mobifu1/arduino_hf_power_meter/messkopf.pdf

# Messkopf fur die LCD-Anzeige ¨

# Aufbau und Abgleich

(c) DL4JAL, Andreas Lindenau
14. Februar 2010

Zusammenfassung
Fur die LCD-Anzeige mit SWR-Messung wird ein Messkopf ben ¨ | ötigt.
Hier folgt die Beschreibung und der Aufbau.

## Der Messkopf-Richtkoppler

Fur die Messung der Vorlaufspannung und R ¨ | ucklaufspannung ben ¨ | ötigen wir
einen Messkopf oder auch Richtkoppler genannt, der diese beiden Messgrößen möglichst frequenzlinear im Frequenzbereich 1,8 MHz bis mindestens 30MHz, besser 50MHz, in eine Gleichspannung umwandelt.

Aufbau des Messkopfes / Richtkopplers

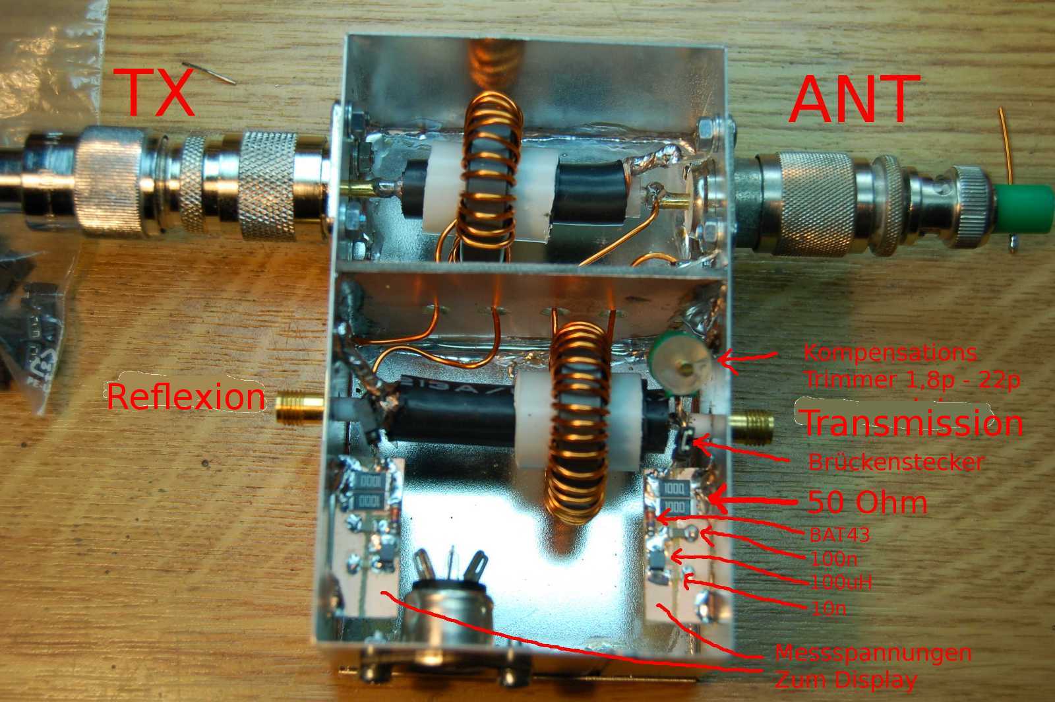
[picture p1: figure]

Ansicht des Messkopfes mit FT-114-43 als Auskopplungselemente. Oben links wird der Sender angeschlossen, oben rechts die Antenne. Die beiden SMA-
Buchsen dienen als Lötstutzpunkt und als Messbuchsen f ¨ | ur den Abgleich. Mit ¨

1

dem Bruckenstecker kann man den 50 Ohm Abschluss abtrennen. Das ist erfor- ¨ derlich wenn wir ein Messkabel anstecken. Auf den kleinen Leiterplatten befinden sich die Abschlusswiderstände 2 x 100 Ohm, die BAT43 zur Gleichrichtung und 2 Kondensatoren zur Glättung und die 100uH Drossel hält die HF von der Displayanzeige fern. Das Metallgehäuse habe ich bei Pollin bestellt fur 3,95 Eu- ¨ ro.

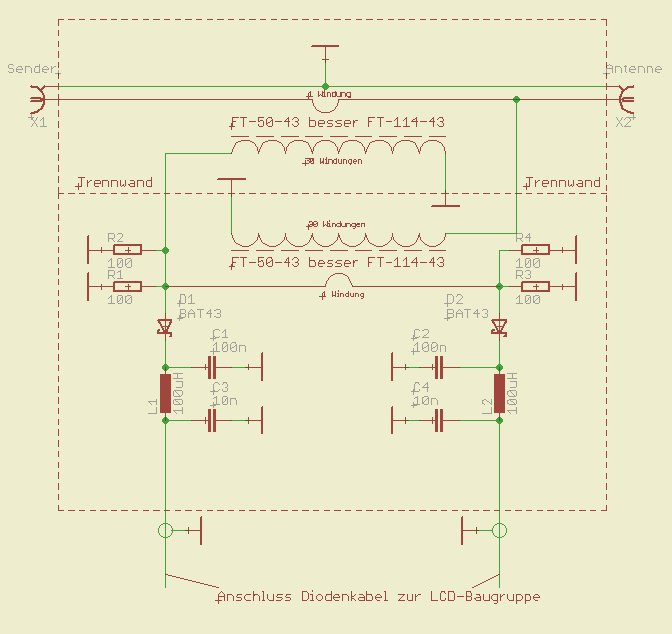
[picture p2: figure]

Das Schaltbild des Richtkopplers.

2

Das Kabel RG213 wird lang abgemantelt. Wir mussen aufpassen dass keine Fa- ¨ sern des Schirmes abstehen und eine Schluss verursachen.

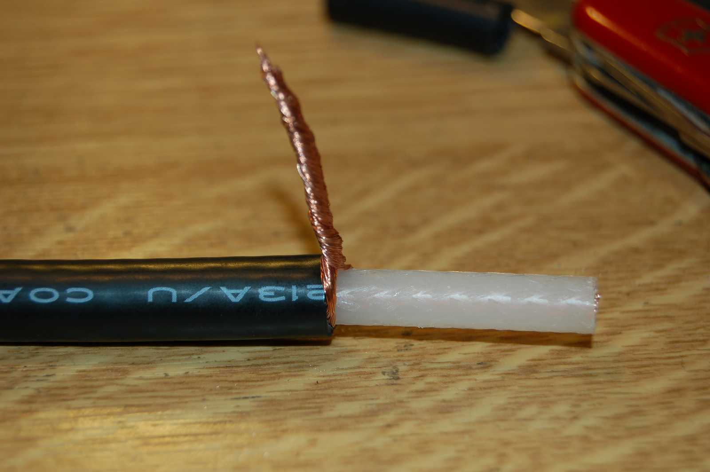
[picture p3: figure]

Deshalb wird die Masse lang verdrillt damit keine Ader frei herumhängt.

3

Die Seele wird ganz kurz abgesetzt um eine maximale Schirmung zu erreichen.

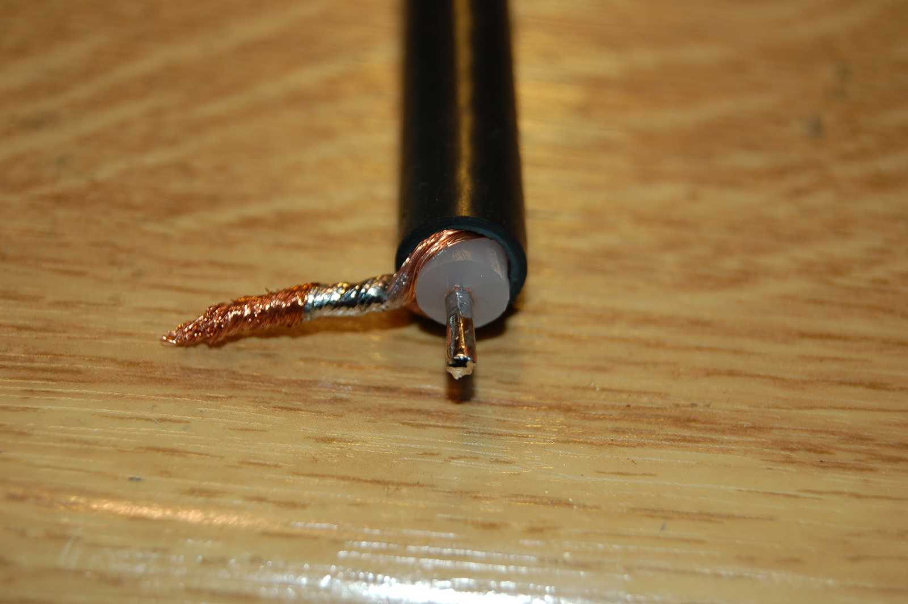
[picture p4: figure]

Masse und Seele gut verzinnen.

4

Die
2 Seite auch kurz absetzen und verzinnen. Achtung der Schirm wird hier abgeschnitten und darauf achten dass keine Fasern in Richtung Seele zeigen!!

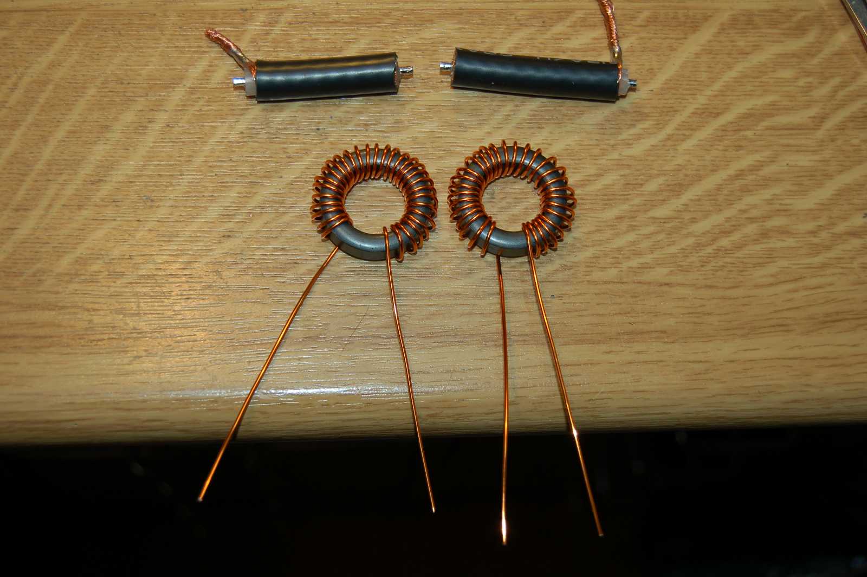
[picture p5: figure]

Wir sehen die fertigen Kabel und die bewickelten Ringkerne. Die Ringkerne bekommen 30 Windungen mit Kupferdraht 1mm Stärke. Es ist gut fur beide Kerne ¨ die gleichen Wickelrichtung zu verwenden. Beachtet man das nicht, kehrt sich die Auskopplung der Reflexion und Transmission um. Das ist nicht so schlimm, aber verwirrt etwas.

5

Die Ringkerne werden auf kurze Plasterohrstucke geschoben. Das Plasterohr ¨ habe ich aus dem Baumarkt. Der Außendurchmesser beträgt 16mm. Zwischen dem Plasterohr und dem RG213 ist noch Luft. Ich habe den Zwischenraum mit Kabelmantel vom RG213 gefullt. ¨

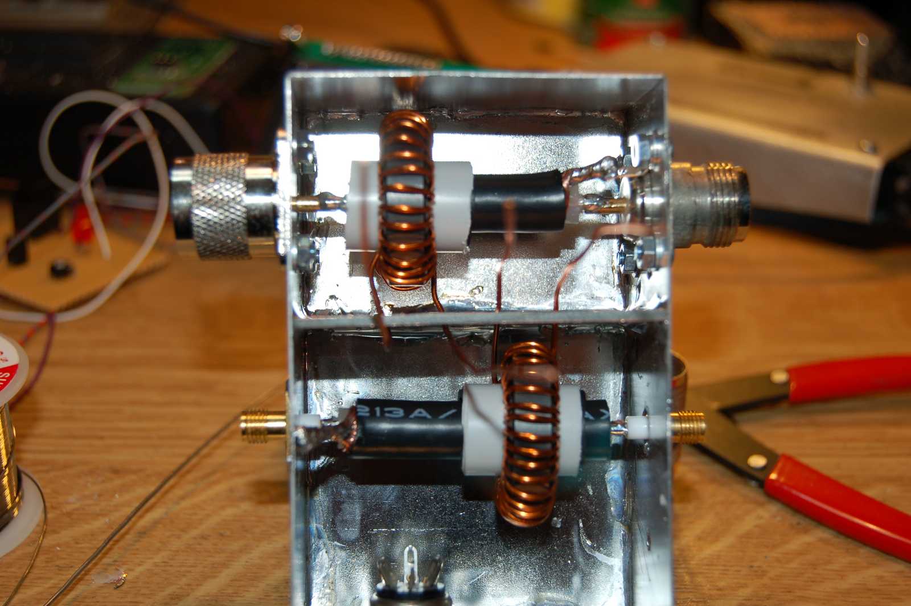
[picture p6: figure]

Sind diese Arbeiten erledigt werden die Kabel eingelötet. Die Drahtenden der Wicklungen durch die Zwischenwandlöcher stecken und die Seelen anlöten. Die verdrillte Masse wird einseitig an Masse gelötet. So wie es im Bild zu sehen ist.

6

Jetzt werden noch die Drahtenden der Ringkernwicklungen angelötet. Wie, erkennt man im Bild.

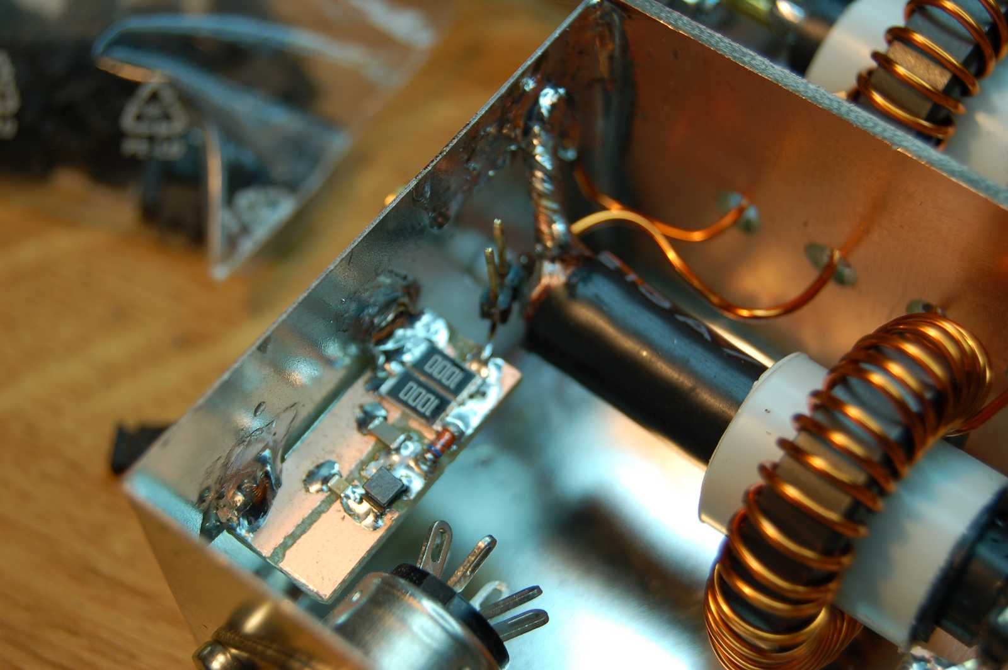
[picture p7: figure]

Wir sehen die eingelötete kleine Leiterplatte mit der Trennbrucke zum Ab- ¨
trennen der 50Ohm fur Messzwecke. Ich habe f ¨ | ur die Steckbr ¨ | ucke abgewinkel- ¨
te Lötleisten verwendet und die Vierkantstift herausgezogen und um 90 Grad versetzt wieder hineingesteckt. Die Lötleisten sind vergoldet und geben guten Kontakt.

7

Hier wird der Trimmer fur die Kompensation der Reflexion eingel ¨ | | ötet. Der Trim-
mer hat 3 Anschlusse. 2 Anschl ¨ | ussen werden mit einem Draht an Masse gel ¨ | ötet
und da ”

heiße“ Ende an die Seele des Koaxialkabels.

Berechnungen zum Messkopf

Als erstes betrachten wir die Parameter, die wir messen wollen. Bei einer erlaubten Sendeleistung von 750 Watt ist der maximale Messbereich auf etwa 1000 Watt festzulegen. Nun Rechnen wir einmal die entstehende Spitzenspannung aus, die an der Seele des Koaxialkabels anliegt.

Spitzenspannung =

√
Leistung ∗ Impedanz ∗ 2

Setzen wir die 1000 Watt ein bekommen wir als Ergebnis 316,22 Volt. Das ist der Idealfall bei einer Impedanz von 50 Ohm. Das SWR beträgt in diesem Fall 1,0.

316, 22V olt =

√
1000W att ∗ 50Ohm ∗ 2

Ist die Antenne fehl angepasst, sieht das wieder ganz anders aus. Nehmen wir mal an, die Antenne hat nicht 50 Ohm sondern durch Fehlanpassung 100 Ohm. Die LCD zeigt ein SWR von 2,0 an. An der Seele des Koaxialkabels steigt die Spannung.

447, 21V olt =

√
1000W att ∗ 100Ohm ∗ 2

Es entsteht also durch diese Fehlanpassung eine Spitzenspannung von 447,21 Volt. Das Messgerät wurde jetzt durch die Fehlanpassung folgende Leistung ¨ anzeigen. In der Software wird die Leistung immer mit 50 Ohm realer Impedanz berechnet, da die Richtung der Fehlanpassung nicht bekannt ist und deshalb auch nicht mit eingerechnet werden kann. Folgende Berechnung verdeutlicht das. Setzen wir die Spitzenspannung in die folgende Formel ein (das ist die

8

Formel fur die Leistungsberechnung in der LCD-Anzeige), dann bekommen wir ¨ als Ergebnis etwa 2000 Watt!!!

Leistung =

Spitzenspannung∗Spitzenspannung Impedanz∗2

1999, 9W att =

447,21∗447,21
50∗2

Das Rechenergebnis erstaunt einen naturlich etwas, aber bei einer Fehlanpas- ¨ sung der Impedanz ist ja nicht bekannt in welche Richtung die Impedanz abweicht. Eine Impedanz von 100 Ohm entspricht einem SWR von 2,0. Aber ein SWR von 2,0 wird auch bei einer Impedanz 25 Ohm angezeigt. Die LCD-Anzeige wurde in diesem Fall aber nur etwa 500 Watt anzeigen. Bei dieser Zahlenspielerei ¨ betrachten wir aber nur den realen Anteil der Impedanz, kommt der imaginäre Anteil der Impedanz noch hinzu werden die Messergebnisse in der LCD-Anzeige weiter verfälscht. Diese Berechnungen bringen mir Klarheit bei der Gesamtkonzeption der LCD-Anzeige. Es ist also erforderlich die Leistungsanzeige bis etwa 2000 Watt auszulegen.

Funktion des Messkopfes

Als Messmethode im Messkopf verwende ich die Transformatorauskopplung fur ¨ die Spannung und den Strom. Einmal ist der Abgleich einfach und damit der Nachbau sicher. Bei einem Richtkoppler brauchen wird eine Stromauskopplung und eine Spannungsauskopplung. Bei diesem Messverfahren werden beide Auskopplungen mit je einem Ringkern praktiziert. Betrachten wir zuerst die Stromauskopplung. Im Kapitel auf Seite 1 sehen wir den Ubertrager ganz oben ¨ in der Abbildung. Links wird der Sender angeschlossen und rechts die Antenne oder eine Dummyload. Als Verbindung zwischen den beiden Punkten benutze ich RG213 Kabel. Wobei die Seele des Kables als 1 Windung durch den Ringkern gefuhrt wird. Der Schirm des Koaxkabels wird nur auf einer Seite an das ¨ Gehäuse angelötet. Durch den Schirm darf kein Strom zuruck fließen. Der Schirm ¨ dient nur als Abschirmung. Der Schirm verhindert eine kapazitive Kopplung zur sekundären Wicklung (30 Windungen) des Ringkernes. Fließt durch die Seele des RG213 Strom wird 1
30 des Stromes zum unteren Teil des Kopplers ubertra- ¨ gen. Dieser Ringkern wird nicht so schnell uberlastet. Der zweite Ringkern auf ¨ dem unteren Koaxialkabel dient zur Spannungsauskopplung. Dieser Ringkern muss die ganze Spannung vertragen, da er mit einem Bein der Wicklung mit der Seele des Koaxialkabels vom TX verbunden ist. Die primäre Wicklung sind in diesem Fall die 30 Windungen und die Seele des unteren Koaxialkabels ist die sekundäre Wicklung mit einer Windung als Auskopplung. Hier gilt auch 1
30
der Spannung wird auf dem unteren Teil des Messkopfes ubertragen. Der Span- ¨ nungsanteil aus dem Stromkoppler wird auf der Seele des unteren Koaxialkabels eingespeist und liegt phasengleich an den Abschlusswiderständen der Reflexion und Transmission an. Die Spannungsauskopplung dagegen induziert an der Seele des unteren Koaxialkabels eine Spannung von links nach rechts betrachtet genau um 180 Grad verschoben ist. Das fuhrt dazu, dass auf der linken Seite im ¨ Bild unten sich beide Spannungen im Anpassungsfall subtrahieren. Es entsteht die Spannung der Reflexion. Auf der rechten Seite des Bildes addieren sich beide Spannungen im Anpassungsfall und es entsteht die Spannung der Transmission. Sobald sich der Widerstand an der Antenne ändert wird an der Reflexion eine

9

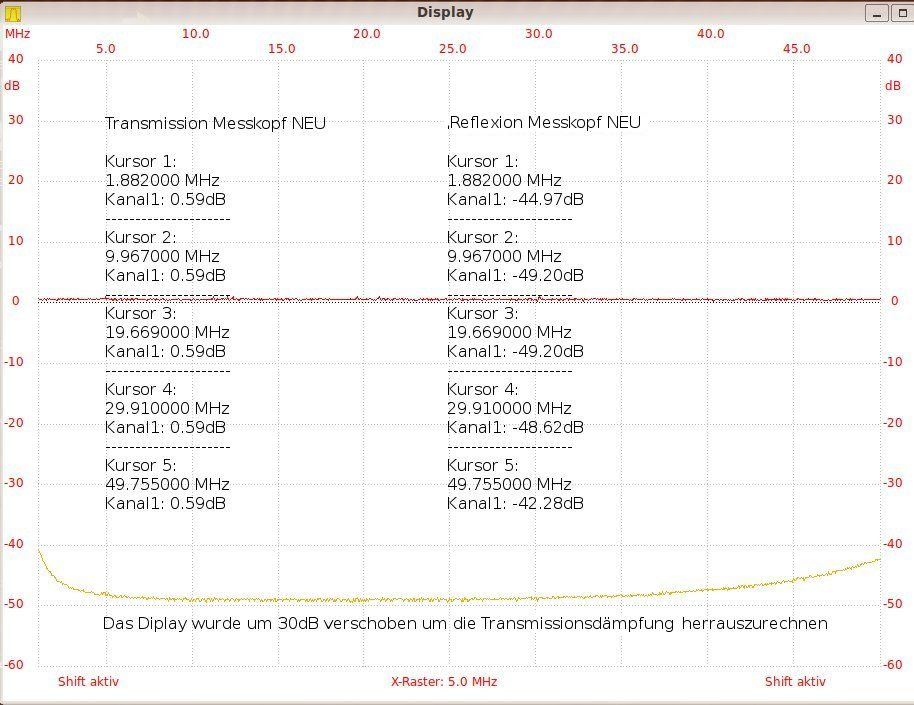
[picture p8: figure]

Abbildung 1: Messung der Reflexion und Transmission

Spannung entstehen, da das Ganze aus dem Gleichgewicht kommt. Ich hoffe mit dieser einfachen Erklärung etwas ”
Licht ins Dunkel“ gebracht zu haben.

Messungen und Abgleich mit NWT01 Netzwerktester

Im einem der vorherigen Abschnitte haben wir festgelegt, das etwa 2000 Watt als Maximum angezeigt werden sollen. Im Messkopf legen wir ein Ubersetzungs- ¨ verhältnis der Spannungen und des Stromes von 1 zu 30 fest. Dieses Uberset- ¨ zungsverhältnis erreichen wir durch 30 Windungen auf den Ringkernen. Mit einem Netzwerktester könne wir die Auskoppeldämpfung der Vorlaufspannung gut messen. Zuerst rechnen wir aus welche Dämpfung in dB mit einer Auskopplung von 1
30 zu erwarten sind.

Daempfung(dB) = 20 ∗ log U2
U1
−29, 54dB = 20 ∗ log 1
30
Wir errechnen -29,54 dB Auskoppeldämpfung fur die Vorlaufspannung (Trans- ¨ mission). Dieses Messergebnis erreichen wir, wenn alle Ausgänge mit 50 Ohm
Impedanz abgeschlossen werden. Die Rucklaufspannung (Reflexion) w ¨ | urde in ¨
diesem Fall 0 Volt betragen oder in dB betrachtet ist die Dämpfung unendlich hoch. Das ist reines Wunschdenken, aber meine Messungen haben gezeigt, dass mit einem Kompensationskondensator der ideale Dämpfungswert von > 40dB erreichbar ist. Das entspricht einer Messgenauigkeit bis etwa SWR 1,02. Ich habe einen Trimmer 1,8p − 22p eingesetzt. Mit diesem Trimmer gleichen wir das

10

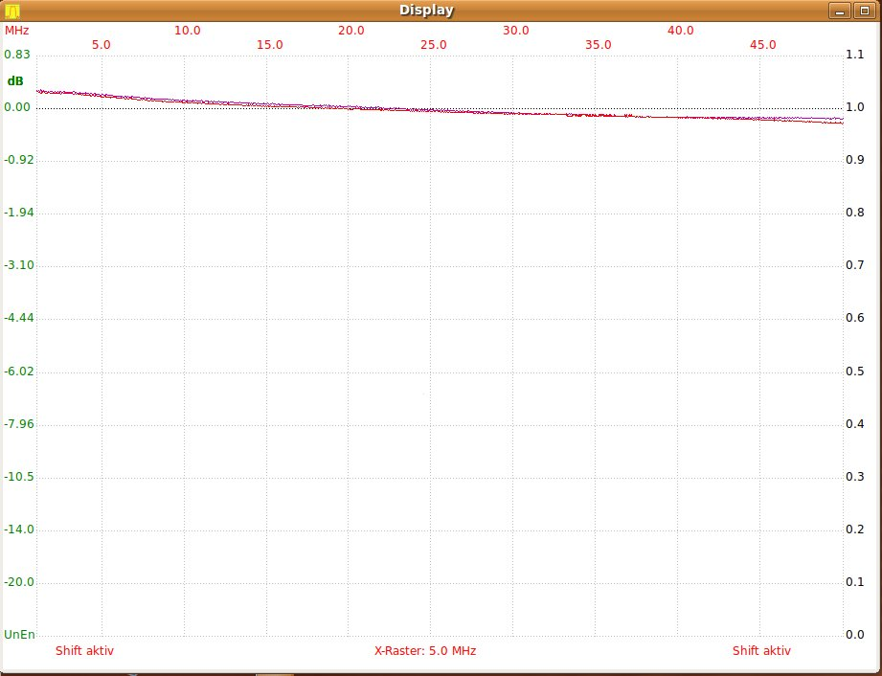
[picture p9: figure]

Abbildung 2: Durchgangsdämpfung Messkopf

ganze ”

Gebilde“ auf ein Reflexionsminimum im Frequenzbereich 1,8 MHz − 30 MHz ab. Beide Messergebnisse sind in der Abbildung 1 auf Seite 10 zu sehen. Ich habe die Displayanzeige um 30dB mit ”

Displayshift“ verschoben um bei der Reflexionsdämpfung nicht rechnen zu mussen. Die Transmission im Bild ist ¨ uber den ganzen Frequenzbereich linear. Die guten Werte der Reflexion erreicht ¨ man nur durch den Abgleich mit dem Kompensationstrimmer. Eine weitere interessante Messung ist die Dämpfung der Sendeleistung durch den Messkopf. Diese Messung habe ich mit dem linearen Messkopf des NWT01 durchgefuhrt. ¨ Wie zu erwarten, ist keine nennenswerte Dämpfung ersichtlich. In Abbildung 2 auf Seite 11 sieht man die beiden Kurven. Die violette Linie ist ohne Messkopf und die rote Linie ist mit Messkopf. Die beiden Linien sind fast deckungsgleich.

## Schlusswort

Ich hoffe das Prinzip des Aufbaus ist gut ruber gekommen. Viel Erfolg beim ¨ Nachbau.
vy 73 Andreas DL4JAL

✉ DL4JAL@darc.de
☎ 037291-68873

11
