mobifu1/arduino_hf_power_meter/(commit log)

2017-12-30 bug fixing Signed-off-by: Mobifu1 <aajahnke@aol.com>
    [hf_power_meter.ino]
2017-12-31 bug fixing for peak value Signed-off-by: Mobifu1 <aajahnke@aol.com>
    [hf_power_meter.ino]
2017-12-31 bud fixing peak Signed-off-by: Mobifu1 <aajahnke@aol.com>
    [hf_power_meter.ino]
2018-03-16 implement ptt interruption by swr or tx-power
